Yu-hotspring/Earphones_amp/CAD/.step

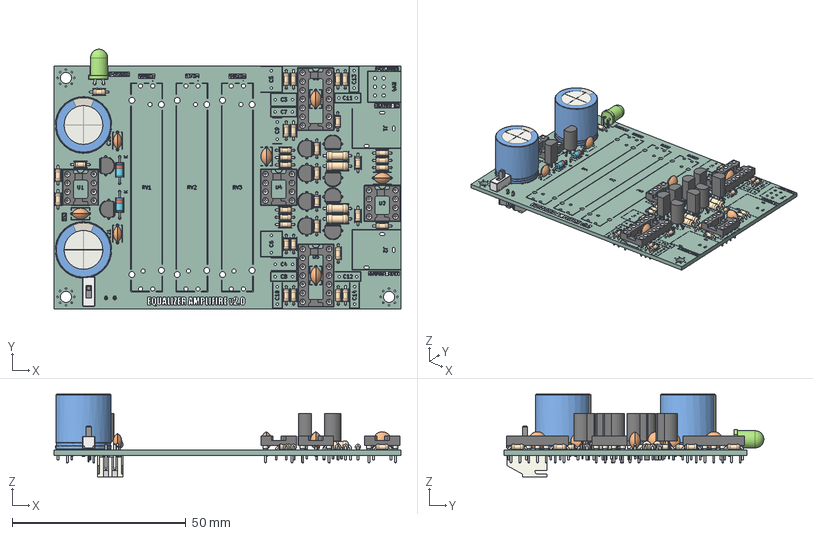
[picture p1: CAD file, 2026-07-22]
CAD/.step
100.0 x 74.9 x 23.8 mm
R_Axial_DIN0204_L3.6mm_D1.6mm_P5.08mm_Horizontal x 34
TO-92L_Inline_Wide x 10
C_Disc_D5.1mm_W3.2mm_P5.00mm x 5
CP_Radial_D16.0mm_P7.50mm x 2
R_Axial_DIN0207_L6.3mm_D2.5mm_P7.62mm_Horizontal x 4
DIP-8_W7.62mm_Socket x 3
DIP-14_W7.62mm_Socket x 2
LED_D5.0mm_Horizontal_O1.27mm_Z3.0mm
D_DO-35_SOD27_P7.62mm_Horizontal x 2
C_Disc_D4.7mm_W2.5mm_P5.00mm x 2
SS12D00G3
JST_XH_S2B-XH-A_1x02_P2.50mm_Horizontal
Earphones_amp_silkscreen x 2
Earphones_amp_PCB
