Yu-hotspring/Earphones_amp/CAD/spaser.SLDPRT

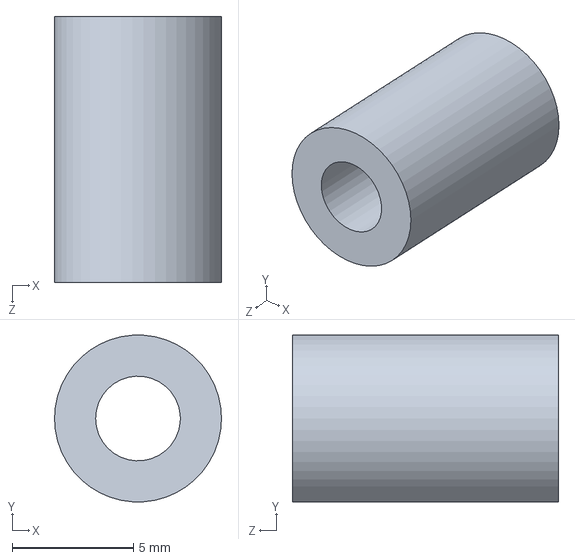
[picture p2: CAD file, 2026-07-22]
CAD/spaser.SLDPRT
6.90 x 6.88 x 11.0 mm
