Yu-hotspring/Earphones_amp/CAD/case1.SLDPRT

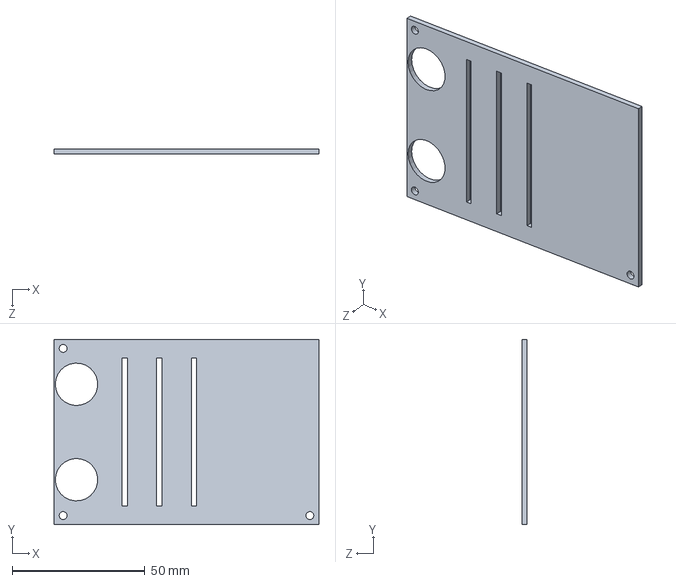
[picture p3: CAD file, 2026-07-22]
CAD/case1.SLDPRT
100.0 x 70.0 x 2.00 mm
