Yu-hotspring/Earphones_amp/CAD/Assem1.SLDASM

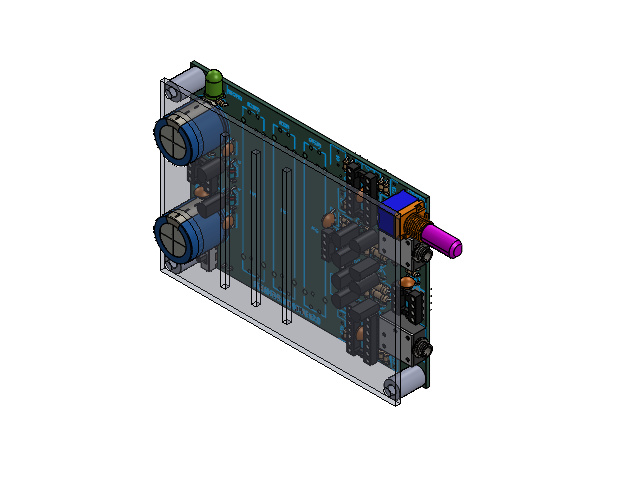
[picture p4: CAD file, 2026-07-22]
CAD/Assem1.SLDASM
case1
spaser x 3
R_Axial_DIN0204_L3.6mm_D1.6mm_P5.08mm_Horizontal_1.step x 34
TO-92L_Inline_Wide_1.step x 10
C_Disc_D5.1mm_W3.2mm_P5.00mm_1.step x 5
CP_Radial_D16.0mm_P7.50mm_1.step x 2
R_Axial_DIN0207_L6.3mm_D2.5mm_P7.62mm_Horizontal_1.step x 4
DIP-8_W7.62mm_Socket_1.step x 3
DIP-14_W7.62mm_Socket_1.step x 2
LED_D5.0mm_Horizontal_O1.27mm_Z3.0mm_1.step
D_DO-35_SOD27_P7.62mm_Horizontal_1.step x 2
C_Disc_D4.7mm_W2.5mm_P5.00mm_1.step x 2
SS12D00G3_1.step
JST_XH_S2B-XH-A_1x02_P2.50mm_Horizontal_1.step
Earphones_amp_silkscreen_1.step
Earphones_amp_silkscreen-0_1.step
Earphones_amp_PCB_1.step
RK09712200HA.stp
MJ-352W-O.stp x 2
