Yu-hotspring/Earphones_amp/(list of files, cad)

Other CAD files:
CAD/C_Disc_D4.7mm_W2.5mm_P5.00mm_1.step.SLDPRT
CAD/CP_Radial_D16.0mm_P7.50mm.step.SLDPRT
CAD/DIP-14_W7.62mm_Socket.step.SLDPRT
CAD/Earphones_amp_silkscreen-0.step.SLDPRT
CAD/TO-92L_Inline_Wide.step.SLDPRT
CAD/JST_XH_S2B-XH-A_1x02_P2.50mm_Horizontal_1.step.SLDPRT
CAD/Earphones_amp_silkscreen_1.step.SLDPRT
CAD/D_DO-35_SOD27_P7.62mm_Horizontal_1.step.SLDPRT
CAD/LED_D5.0mm_Horizontal_O1.27mm_Z3.0mm.step.SLDPRT
CAD/LED_D5.0mm_Horizontal_O1.27mm_Z3.0mm_1.step.SLDPRT
CAD/Earphones_amp_silkscreen-0_1.step.SLDPRT
CAD/DIP-8_W7.62mm_Socket.step.SLDPRT
CAD/R_Axial_DIN0207_L6.3mm_D2.5mm_P7.62mm_Horizontal_1.step.SLDPRT
CAD/C_Disc_D5.1mm_W3.2mm_P5.00mm_1.step.SLDPRT
CAD/SS12D00G3_1.step.SLDPRT
CAD/SS12D00G3.step.SLDPRT
CAD/R_Axial_DIN0204_L3.6mm_D1.6mm_P5.08mm_Horizontal_1.step.SLDPRT
CAD/D_DO-35_SOD27_P7.62mm_Horizontal.step.SLDPRT
CAD/DIP-8_W7.62mm_Socket_1.step.SLDPRT
CAD/Earphones_amp_PCB_1.step.SLDPRT
CAD/C_Disc_D5.1mm_W3.2mm_P5.00mm.step.SLDPRT
CAD/C_Disc_D4.7mm_W2.5mm_P5.00mm.step.SLDPRT
CAD/R_Axial_DIN0207_L6.3mm_D2.5mm_P7.62mm_Horizontal.step.SLDPRT
CAD/JST_XH_S2B-XH-A_1x02_P2.50mm_Horizontal.step.SLDPRT
CAD/R_Axial_DIN0204_L3.6mm_D1.6mm_P5.08mm_Horizontal.step.SLDPRT
CAD/DIP-14_W7.62mm_Socket_1.step.SLDPRT
CAD/Earphones_amp_silkscreen.step.SLDPRT
CAD/Earphones_amp_PCB.step.SLDPRT
CAD/CP_Radial_D16.0mm_P7.50mm_1.step.SLDPRT
CAD/TO-92L_Inline_Wide_1.step.SLDPRT
CAD/.step.SLDASM
