Yu-hotspring/Earphones_amp/(commit log)

2026-01-16 回路図Done LT->DT
    [Earphones_amp.kicad_sch]
2026-01-16 部品紐づけ進めた
    [Earphones_amp.kicad_sch]
2026-06-23 回路図完成
    [Earphones_amp.kicad_pcb, Earphones_amp.kicad_sch]
2026-06-23 PCBすすめた
    [Earphones_amp.kicad_pcb, Earphones_amp.kicad_sch]
2026-06-23 部品置いた
    [Earphones_amp.kicad_pcb, Earphones_amp.kicad_sch]
2026-06-26 gbr出力
    [Earphones_amp.kicad_pcb, Earphones_amp.kicad_sch]
2026-06-26 シルク追記，gbr更新
    [Earphones_amp.kicad_pcb]
2026-07-11 回路図修正，v2.0に更新
    [Earphones_amp.kicad_pcb, Earphones_amp.kicad_sch]
2026-07-13 回路図更新
    [Earphones_amp.kicad_sch]
2026-07-22 add:CAD file
    [.step, .step.SLDASM, Assem1.SLDASM, CP_Radial_D16.0mm_P7.50mm.step.SLDPRT, CP_Radial_D16.0mm_P7.50mm_1.step.SLDPRT, C_Disc_D4.7mm_W2.5mm_P5.00mm.step.SLDPRT, C_Disc_D4.7mm_W2.5mm_P5.00mm_1.step.SLDPRT, C_Disc_D5.1mm_W3.2mm_P5.00mm.step.SLDPRT]
